DevCheckOG/SPIRIT/EDA-kicad/component-libs/SPIRIT-3D-models/USB-SWITCH-2CHANNEL-TS3USB221AQRSERQ1.stp

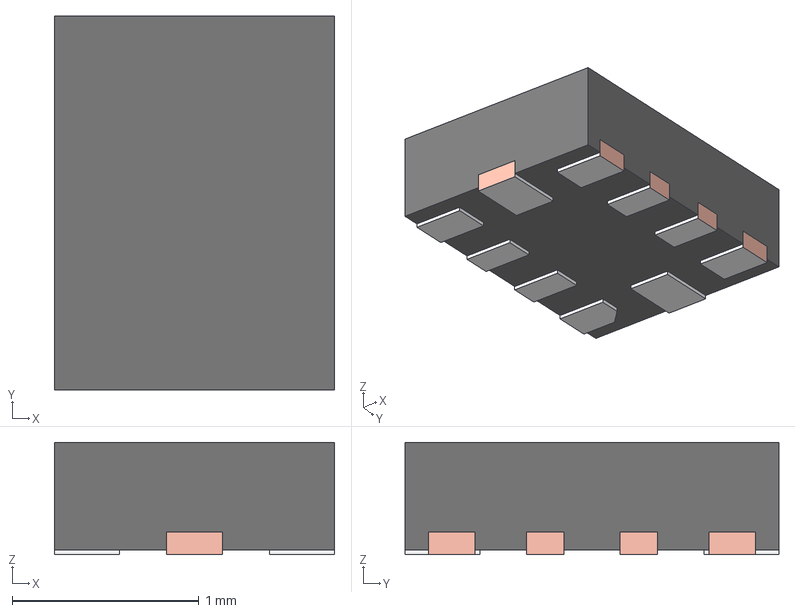
[picture p2: CAD file, 2026-04-25]
EDA-kicad/component-libs/SPIRIT-3D-models/USB-SWITCH-2CHANNEL-TS3USB221AQRSERQ1.stp
1.50 x 2.00 x 0.6 mm
FRAME-RSE0010A
BODY-QFN
PIN1-ID
