DevCheckOG/SPIRIT/EDA-kicad/component-libs/SPIRIT-3D-models/USB-MUX-RHR0028A.stp

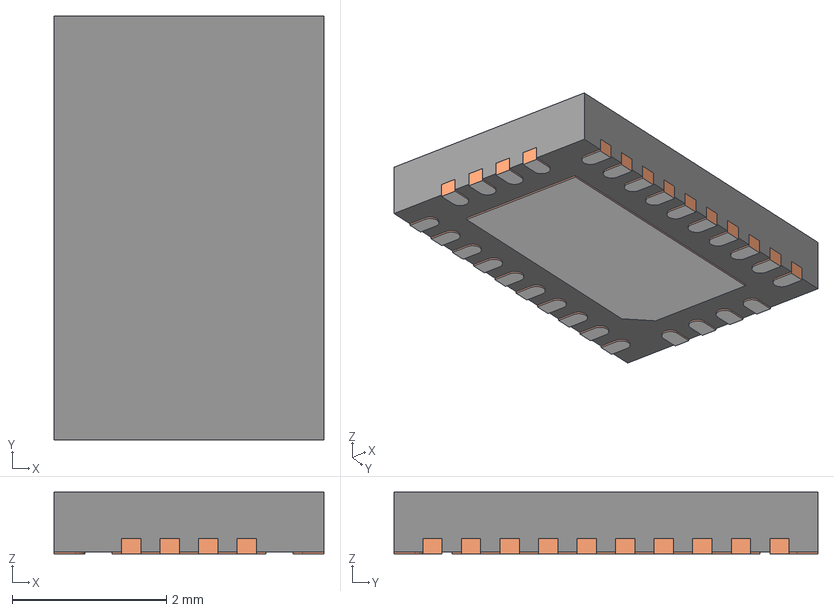
[picture p3: CAD file, 2026-04-25]
EDA-kicad/component-libs/SPIRIT-3D-models/USB-MUX-RHR0028A.stp
3.50 x 5.50 x 0.8 mm
BODY-QFN
FRAME-RHR0028A
PIN1-ID
