DevCheckOG/SPIRIT/EDA-kicad/cm5-carrier.kicad_pcb

## KiCad design EDA-kicad/cm5-carrier.kicad_pcb (2026-04-25)

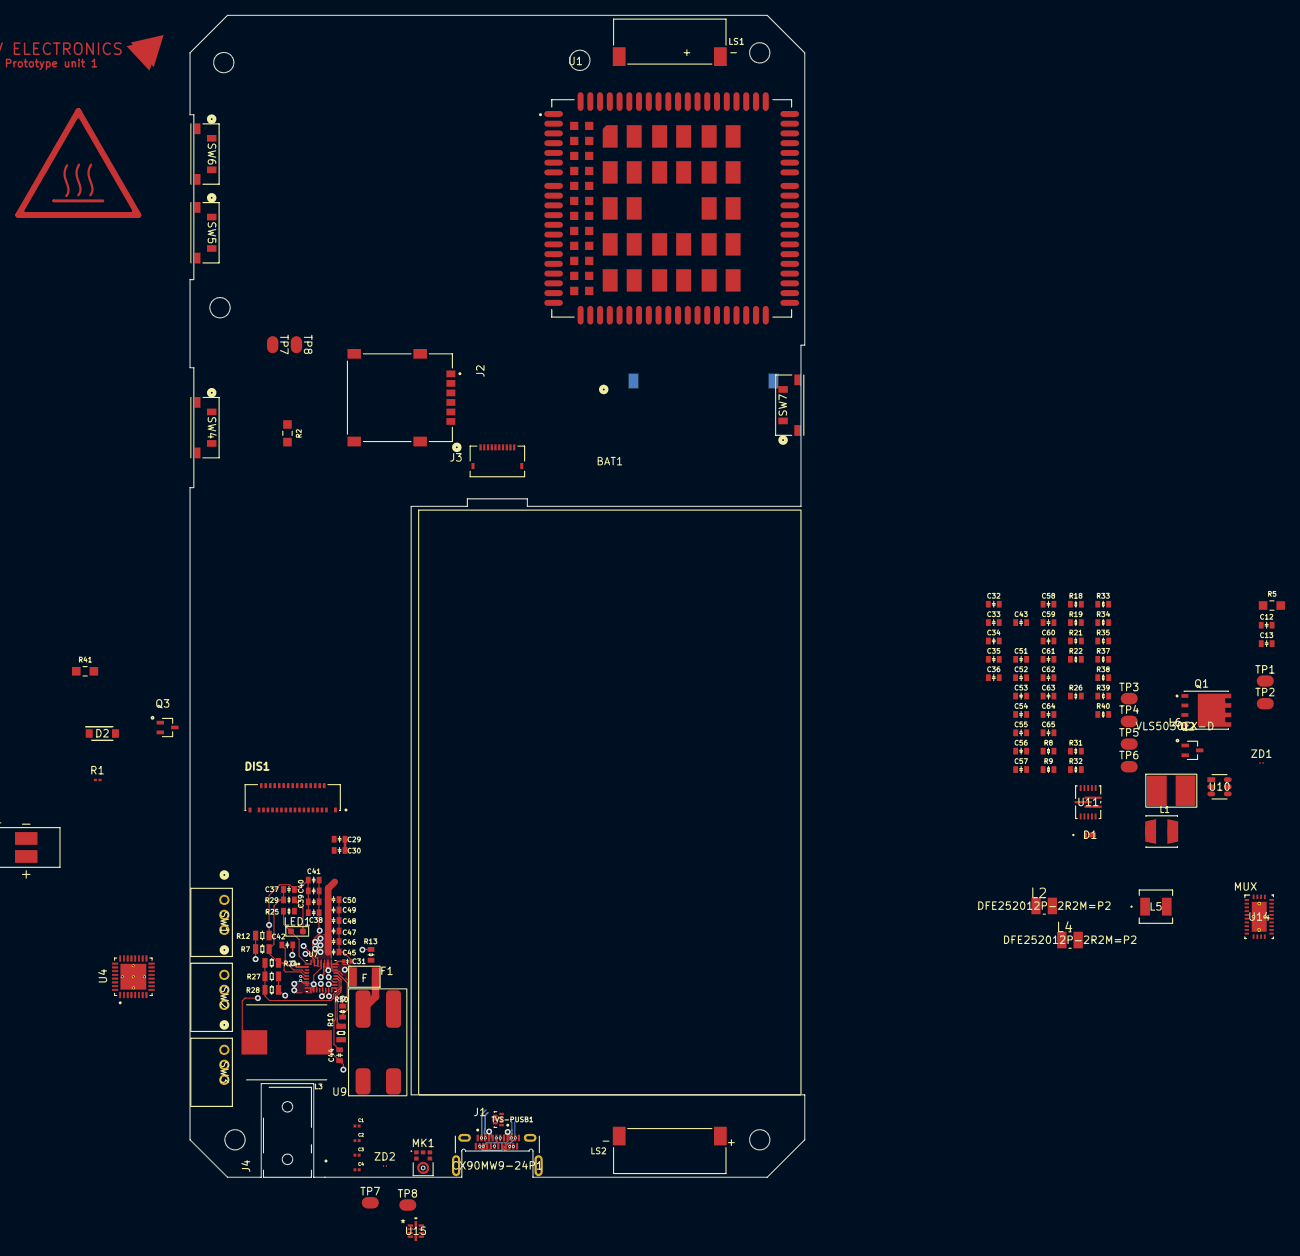
[picture p4: board cm5-carrier.kicad_pcb from above]

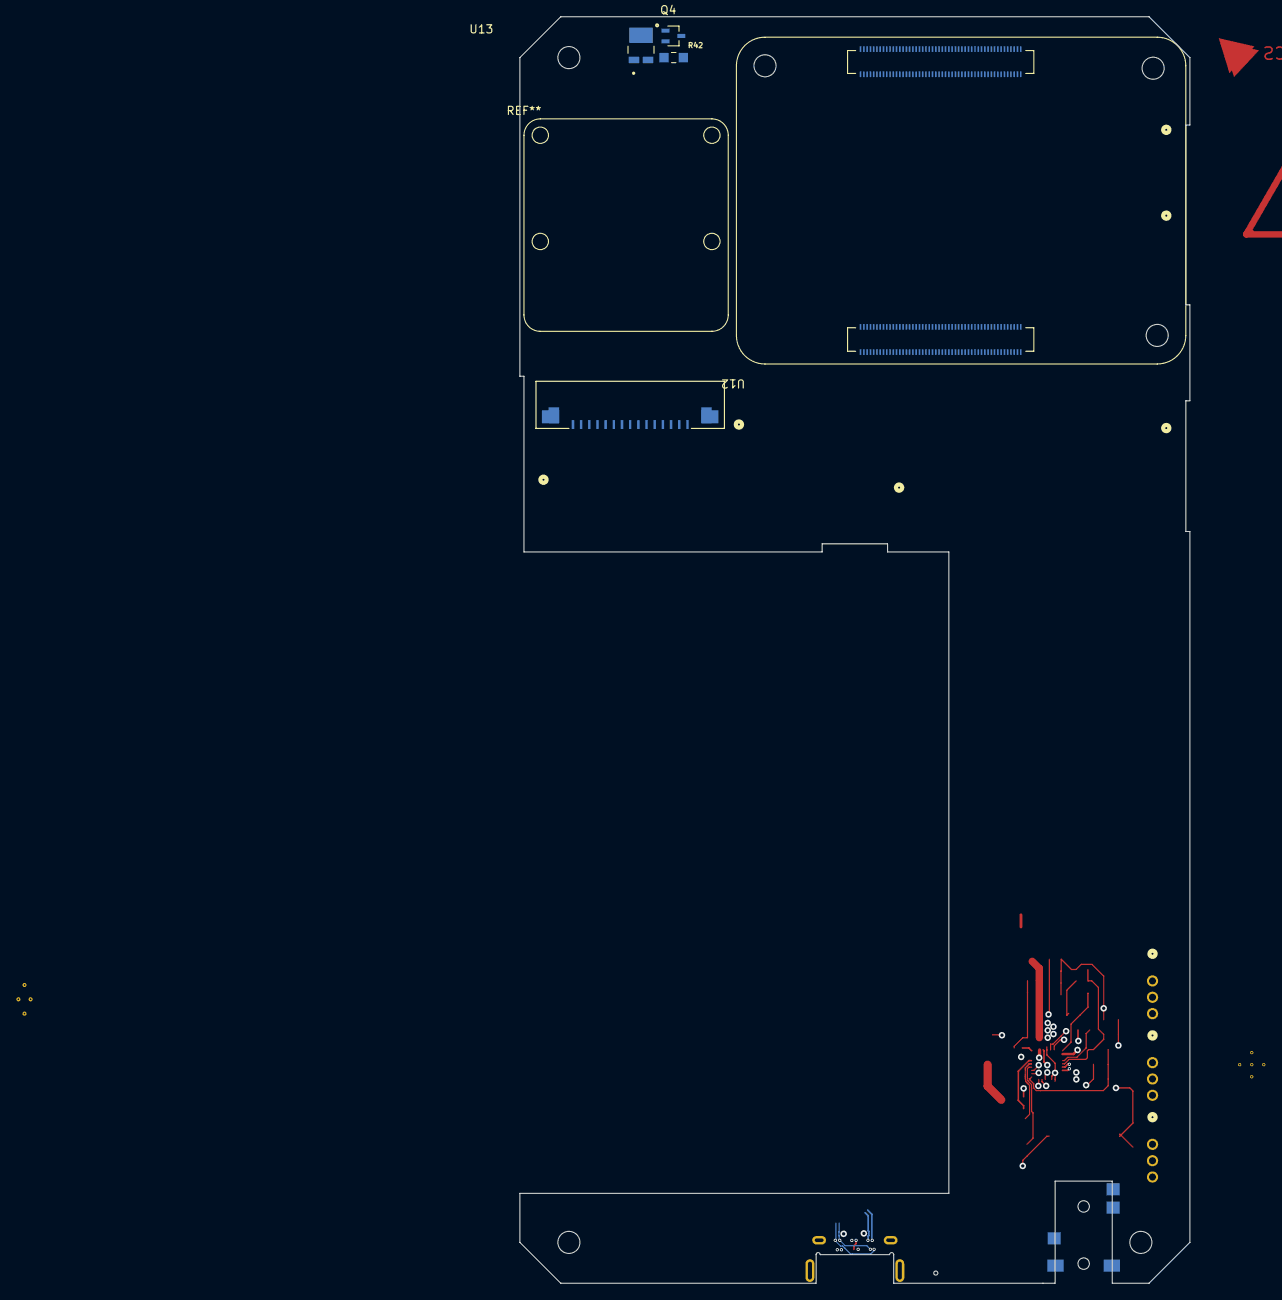
[picture p5: board cm5-carrier.kicad_pcb from below]

Board: 6 copper layers, 82.0 x 155.0 mm, 129 parts (5 on the bottom side), 101 nets.

Parts:
B1: VIBR; VIBRATION-PUI_HD-EMB1205-3-SC-R
BAT1: Li-ion-3.7 35Ah; battery_37V3500mAhLP685077JU
C1, C2, C3, C4: 0.33 µF coupling cap; USBC_capacitor_CAPC0603X33N
C12: 200pF; 0603-capacitor
C13, C38, C45, C55, C59: 0.1uF; 0603-capacitor
C29, C30, C33, C34, C35, C39, C40, C41, C46, C47, C48, C49, C50: 10uF; 0603-capacitor
C31: 1nF 50V; 0402-capacitor
C32, C53, C54: 1uF; 0603-capacitor
C36, C43, C51, C56, C57, C58, C60, C61, C62, C65: 22uF; 0603-capacitor
C37, C52, C64: 4.7uF; 0603-capacitor
C42, C44: 47nF; 0603-capacitor
C63: 6.8nF; 0603-capacitor
D1: D_Schottky; schottky-diode-CR_DSN2_152AB-C_OSI
D2: 1N4007W-T; flyback-diode-SODFL3818X130N
DIS1: FH72-31S-0.3SHW; HRS_FH72-31S-0.3SHW
F1: 9A 6V; PTC RESET FUSE 9.0A 6V 1210 1210L900SLPR
J1: USBC-4-0-CX90MW9-24P1; USB-4-0-HIROSE_CX90MW9-24P1
J2: SIM-G85D1160022HHR; SIM-AMPHENOL_G85D1160022HHR
J3: FINGER; 10PIN
J4: SJ2-35894B-SMT-TR; 35mmJACK-CUI_SJ2-35894B-SMT-TR
L1: 3.3uH; 3-3uH-MURATA_LQH44PN3R3MPRL
L2, L4: 2.2uH; 2-2uH-inductor-INDC2520X120N
L3: 2.2uH; 2-2uh-inductorIND_ETQP4M2R2KVC
L5: 6.8uH; 6-8uH-inductor-LQH44PN6R8MPRLIND_LQH44PN_PR_MUR
L6: 1.5uH; 1-5uH-inductor-VLS5030EX-D
LED1: 5mA 2V Fv; LED-INDICATOR-RED-QBLP601-R5
LS1, LS2: CMR-15062S-67; SPEAKER_CMR-15062S-67
MK1: microphone; microphone_SPH0645LM4H-B
Module1: ComputeModule5-CM5; Raspberry-Pi-5-Compute-Module
Q1: NMOS-BSC0902NSIATMA1-PG-TDSON-8-6-IC_ISC037N03L5ISATMA1
Q2, Q3, Q4: gpio-driver-transistor-fix-SOT65P210X110-3N
R1: thermistor; thermistor-NTC0201Z_P63XP33_PAN
R2: 270KΩ 0.5W; 1K-05W-0805-RES_ERJP06J102V
R5: 100KΩ; 100K-0805-resistor-RES_ERA6AEB104V
R7: 127kΩ; 0805-resistor
R8, R9: 10k; 0603-resistor
R10: 4.7KΩ; 0805-resistor
R12: 100kΩ; 0805-resistor
R13: 100Ω; 0603-resistor
R18, R31, R32, R33: 100kΩ; 0603-resistor
R19: 680kΩ 1%; 0603-resistor
R21, R26: 470kΩ 1%; 0603-resistor
R22: 1MΩ 1%; 0603-resistor
R24: 5.23kΩ; 0805-resistor
R25, R30: 10kΩ; 0603-resistor
R27: 10kΩ; 0805-resistor
R28: 30kΩ; 0805-resistor
R29: 680Ω; 0603-resistor
R34: 820kΩ; 0603-resistor
R35: 182KΩ; 0603-resistor
R37: 5Ω; 0603-resistor
R38: 750kΩ; 0603-resistor
R39: 200kΩ; 0603-resistor
R40: 6.8kΩ; 0603-resistor
R41, R42: 1KΩ 0.5W; 1K-05W-0805-RES_ERJP06J102V
SW1: EG25-switch-CSS-1210MC; privacy-switch-SW3_CSS-1210MC_NDC
SW2: MIC-switch-CSS-1210MC; privacy-switch-SW3_CSS-1210MC_NDC
SW3: CAM-switch-CSS-1210MC; privacy-switch-SW3_CSS-1210MC_NDC
SW4: PROG; buttonSW_TL3330_EWI
SW5: VOL-; buttonSW_TL3330_EWI
SW6: VOL+; buttonSW_TL3330_EWI
SW7: POW; buttonSW_TL3330_EWI
TP1, TP2, TP3, TP4, TP5, TP6, TP7, TP7#2, TP8, TP8#2: test-pad-1
TVS-PUSB1: TVS-array-IC_PUSB3AB6Z
U1: EG25GGC-128-SGNS; XCVR_EG25GGC-128-SGNS
U4: CODEC-TLV320AIC3204IRHBR; CODEC-QFN50P500X500X100-33N
U7: BQ25792RQMR; charger-bq25792-QFN40P400X400X100-29N
U9: BAT-CONNECTOR-FLTS22WR00
U10: 22V-boost-AP3032KTR-G1; SOT23-6_DIO
U11: MP3429GL-Z; QFN-3x4_MP3429_MNP
U12: FPC15pin-1mm-pitch-F52Q-1A7H1-11015; FPC15pin-1mm-pitch-CONN_F52Q-1A7H1-11015_AMP
U13: Flash-LED-Lumiled; LUMILED-DIODFN449X305X210-3N
U14: HD3SS460RHRR; USB-MUX-RHR0028A
U15: USB SWITCH 2CHANNEL TS3USB221AQRSERQ1; USB-SWITCH-2CHANNEL-TS3USB221AQRSERQ1
ZD1, ZD2: protection-PESD5V0C1USFYL; USB-ESD-protection-diode-PESD5V0C1USFYL-SOD962-2_DSN0603-2_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

Connections:
1V8: DIS1.25, SW2.1, U4.24 (AVDD), U4.29 (DVDD)
3V3B: DIS1.30, Module1.78 (GPIO_VREF(1.8v/3.3v_Input)), Q2.3 (S), R8.2, R9.1, R25.2, R30.1, R31.1, R32.1, R33.2, SW3.1, U4.6 (IOVDD), U4.26 (LDOIN/HPVDD), U4.30 (LDO_SELECT)
5V: C59.1, C60.1, C61.1, C62.1, Module1.77 (+5v_(Input)), Module1.79 (+5v_(Input)), Module1.81 (+5v_(Input)), Module1.83 (+5v_(Input)), Module1.85 (+5v_(Input)), Module1.87 (+5v_(Input)), R38.1, U11.8 (VOUT)
22V: C53.1, D1.1 (K), DIS1.2, U10.5 (OV)
AGND: C65.2, R39.2, R40.2, U11.6 (AGND), U11.9 (FTY)
AUDIO_BCLK_I2S: MK1.4 (BCLK), Module1.49 (GPIO18), U4.2 (BCLK)
AUDIO_MCLK: Module1.54 (GPIO4), U4.1 (MCLK)
AUDIO_MIC_DATA: Module1.27 (GPIO20), U4.5 (DOUT/MFP2)
AUDIO_RESET: Module1.45 (GPIO24), U4.31 (~RESET)
AUDIO_SCL: Module1.51 (GPIO15), U4.9 (SCL/~SS)
AUDIO_SDA: Module1.31 (GPIO12), U4.10 (SDA/MOSI)
AUDIO_SOUND_DATA: Module1.25 (GPIO21), U4.4 (DIN/MFP1)
AUDIO_WCLK_I2S: MK1.1 (WS), Module1.26 (GPIO19), U4.3 (WCLK)
BACKLIGHT-: DIS1.31, R37.1, U10.3 (FB)
BAT+: C29.1, C30.1, F1.2, R13.2, U7.22 (BAT), U7.23 (BAT__1)
CAM-SWITCH: TP7.1 (A), U12.15
CAM_CK_N: Module1.127 (MIPI0_C_N), U12.8
CAM_CK_P: Module1.129 (MIPI0_C_P), U12.9
CAM_D0_N: Module1.115 (MIPI0_D0_N), U12.2
CAM_D0_P: Module1.117 (MIPI0_D0_P), U12.3
CAM_D1_N: Module1.121 (MIPI0_D1_N), U12.5
CAM_D1_P: Module1.123 (MIPI0_D1_P), U12.6
CAM_IO0: TP8.1 (A), U12.11
CC1: J1.A5 (CC1), Module1.94 (CC1)
CC2: J1.B5 (CC2), Module1.96 (CC2)
D+: J1.A6 (D1+), J1.B6 (D2+), Module1.163 (USB3-1-D_P), TVS-PUSB1.5 (D+), U7.6 (D+)
D-: J1.A7 (D1-), J1.B7 (D2-), Module1.165 (USB3-1-D_N), TVS-PUSB1.4 (D-), U7.7 (D-)
DEFDCDC1 DIVIDER: C36.1, L1.1, R34.1
DSI1_C_N: DIS1.11, Module1.187 (MIPI1_C_N)
DSI1_C_P: DIS1.12, Module1.189 (MIPI1_C_P)
DSI1_D0_N: DIS1.5, Module1.175 (MIPI1_D0_N)
DSI1_D0_P: DIS1.6, Module1.177 (MIPI1_D0_P)
DSI1_D1_N: DIS1.8, Module1.181 (MIPI1_D1_N)
DSI1_D1_P: DIS1.9, Module1.183 (MIPI1_D1_P)
DSI1_D2_N: DIS1.14, Module1.133 (MIPI0_D2_N), Module1.193 (MIPI1_D2_N)
DSI1_D2_P: DIS1.15, Module1.135 (MIPI0_D2_P), Module1.195 (MIPI1_D2_P)
GND: C12.1, C13.2, C29.2, C30.2, C31.2, C32.2, C33.2, C34.2, C35.2, C36.2, C37.2, C38.2, C39.2, C40.2, C41.2, C43.2, C45.2, C46.2, C47.2, C48.2, C49.2, C50.2, C51.2, C52.1, C53.2, C54.2, C56.2, C57.2, C58.2, C59.2, C60.2, C61.2, C62.2, C64.1, DIS1.1, DIS1.4, DIS1.7, DIS1.10, DIS1.13, DIS1.16, DIS1.19, DIS1.20, J1.A1 (GND_A), J1.A12 (GND_A__1), J1.B1 (GND_B), J1.B12 (GND_B__1), J1.SH1 (SHIELD), J1.SH2 (SHIELD__1), J1.SH3 (SHIELD__2), J1.SH4 (SHIELD__3), J2.C5 (GND), J2.S1 (SHIELD_GND), J2.S2 (SHIELD_GND__1), J2.S3 (SHIELD_GND__2), J3.1, J4.1, MK1.2 (SELECT), MK1.3 (GND), Module1.1 (GND), Module1.2 (GND), Module1.8 (GND), Module1.13 (GND), Module1.14 (GND), Module1.22 (GND), Module1.23 (GND), Module1.32 (GND), Module1.33 (GND), Module1.42 (GND), Module1.43 (GND), Module1.52 (GND), Module1.53 (GND), Module1.60 (GND), Module1.66 (GND), Module1.71 (GND), Module1.74 (GND), Module1.98 (GND), Module1.107 (GND), Module1.108 (GND), Module1.113 (GND), Module1.114 (GND), Module1.119 (GND), Module1.120 (GND), Module1.125 (GND), Module1.126 (GND), Module1.131 (GND), Module1.132 (GND), Module1.137 (GND), Module1.138 (GND), Module1.144 (GND), Module1.150 (GND), Module1.155 (GND), Module1.156 (GND), Module1.161 (GND), Module1.162 (GND), Module1.167 (GND), Module1.168 (GND), Module1.173 (GND), Module1.174 (GND), Module1.179 (GND), Module1.180 (GND), Module1.185 (GND), Module1.186 (GND), Module1.191 (GND), Module1.192 (GND), Module1.197 (GND), Module1.198 (GND), Q3.3 (S), Q4.3 (S), R5.1, R10.1, R12.2, R21.1, R26.1, R27.2, R28.2, R35.1, R37.2, TVS-PUSB1.2 (GND), U4.7 (IOVSS), U4.12 (SPI_SELECT), U4.17 (AVSS), U4.28 (DVSS), U4.33 (EP), U7.10 (ACDRV2), U7.11 (ACDRV1), U7.27 (GND), U9.4 (OUT-), U10.2 (GND), U11.7 (PGND), U12.1, U12.4, U12.10, ZD1.2, ZD2.2
GPIO2: Module1.58 (GPIO2), SW7.2
GPIO3: Module1.56 (GPIO3), SW6.2
GPIO17: Module1.50 (GPIO17), SW4.2
GPIO22: Module1.46 (GPIO22), R42.1
GPIO27: Module1.48 (GPIO27), R41.1
JACK_MIC: J4.4, U4.8 (SCLK/MFP3)
LCD_PWM: Module1.55 (GPIO14), U10.4 (CTRL)
MIC-SWITCH: C12.2, C13.1, MK1.5 (VDD)
unnamed: C63.2, R40.1
unnamed: D1.2 (A), L5.2, U10.1 (SW)
unnamed: J3.8, R2.2
unnamed: LED1.2 (A), R29.1
unnamed: LED1.1 (K), R25.1, U7.1 (STAT)
unnamed: MK1.6 (DATA_OUT), R5.2
unnamed: C1.1, Module1.157 (USB3-1-RX_N)
unnamed: C2.1, Module1.159 (USB3-1-RX_P)
unnamed: C3.1, Module1.169 (USB3-1-TX_N)
unnamed: C4.1, Module1.171 (USB3-1-TX_P)
unnamed: Q2.1 (G), SW3.2
unnamed: B1.N, D2.2, Q3.2 (D)
unnamed: Q3.1 (G), R41.2
unnamed: Q4.2 (D), U13.1 (-)
unnamed: Q4.1 (G), R42.2
unnamed: C52.2, TP5.1 (A)
unnamed: R13.1, U7.18 (BATP)
unnamed: C42.2, U7.4 (BTST1)
unnamed: C44.2, U7.19 (BTST2)
unnamed: R7.1, R12.1, U7.17 (ILIM_HIZ)
unnamed: C38.1, C39.1, C40.1, C41.1, U7.29 (PMID)
unnamed: R10.2, U7.20 (PROG)
unnamed: C31.1, U7.24 (SDRV)
unnamed: C42.1, L3.2, U7.28 (SW1)
unnamed: C44.1, L3.1, U7.26 (SW2)
unnamed: R24.2, R27.1, R28.1, U7.16 (TS)
unnamed: R34.2, R35.2
unnamed: R22.1, R26.2
unnamed: R19.1, R21.2
unnamed: C32.1, R18.1
unnamed: C43.1, L2.1
unnamed: C51.1, L4.1
unnamed: F1.1, U9.3 (OUT+)
unnamed: C55.1, U11.13 (BST)
unnamed: C63.1, U11.4 (COMP)
unnamed: R38.2, R39.1, U11.5 (FB)
unnamed: C65.1, U11.3 (SS)
unnamed: C55.2, L6.2, U11.1 (SW)
unnamed: C64.2, U11.2 (VDD)
REGN: C37.1, R7.2, R24.1, R29.2, U7.5 (REGN)
RX1+: C2.2, J1.A11 (RX2+), J1.B11 (RX1+), TVS-PUSB1.7 (RX+)
RX1-: C1.2, J1.A10 (RX2-), J1.B10 (RX1-), TVS-PUSB1.6 (Rx-)
SCL PWR: Module1.80 (SCL0), U7.14 (SCL)
SDA PWR: Module1.82 (SDA0), U7.15 (SDA)
SPI0_CLK: J3.2, Module1.38 (GPIO11)
SPI0_CS: J3.5, Module1.39 (GPIO8)
SPI0_MISO: J3.3, Module1.40 (GPIO9)
SPI0_MOSI: J3.4, Module1.44 (GPIO10)
SPI0_RDY: J3.6, Module1.34 (GPIO5)
SYS: C45.1, C46.1, C47.1, C48.1, C49.1, C50.1, C54.1, C56.1, C57.1, C58.1, L5.1, L6.1, R19.2, R22.2, U7.25 (SYS), U10.6 (VIN), U11.10 (MODE), U11.11 (EN), U11.12 (VIN)
TX1+: C4.2, J1.A2 (TX1+), J1.B2 (TX2+), TVS-PUSB1.3 (Tx+)
TX1-: C3.2, J1.A3 (TX1-), J1.B3 (TX2-), TVS-PUSB1.1 (Tx-)
USBC POW: J1.A4 (VBUS_A), J1.A9 (VBUS_A__1), J1.B4 (VBUS_B), J1.B9 (VBUS_B__1), U7.2 (VBUS), U7.8 (VAC2), U7.9 (VAC1), ZD1.1, ZD2.1
VCC: B1.P, D2.1, J3.7, J3.10, R2.1, SW4.1, SW5.1, SW6.1, SW7.1, U13.2 (+)
~BQ INT: R30.2, U7.21 (~INT)
~TPS INT: R31.2, TP6.1 (A)
