DevCheckOG/SPIRIT/(commit log)

2026-03-19 fix bad label 3V3
    [power.kicad_sch]
2026-03-19 pull up I2C line of TPS
    [power.kicad_sch]
2026-03-19 Fixed audio schematic file name
    [audio.kicad_sch, cm5-carrier.kicad_sch, power.kicad_sch]
2026-03-19 Finished audio schematic
    [audio.kicad_sch, cm5-carrier.kicad_sch]
2026-03-22 change netflaf for microphone switch to be 1V8 instead of 3V3B, GPS/GSM symbol
    [GSM-GPS.kicad_sch, power.kicad_sch]
2026-03-22 reannotate entire schematic
    [GSM-GPS.kicad_sch, USB-C.kicad_sch, audio.kicad_sch, buttons.kicad_sch, camera.kicad_sch, cm5-carrier.kicad_sch, fingerprint.kicad_sch, flashlight.kicad_sch]
2026-03-22 broken connection, change flags to 3V3B labels
    [power.kicad_sch]
2026-03-22 screen GND ref
    [screen.kicad_sch]
2026-03-22 charger 50% routed
    [cm5-carrier.kicad_pcb, cm5-carrier.kicad_sch, power.kicad_sch]
2026-03-23 update schematic PDF
2026-03-24 connect GPIO VREF to 3V3B
    [cm5-carrier.kicad_sch]
2026-03-24 remove redundant pull ups, connect charger and PMIC on single I2C bus
    [cm5-carrier.kicad_sch, power.kicad_sch]
2026-03-24 routed charger
    [cm5-carrier.kicad_pcb]
2026-03-24 add MPN to USB C symbol
    [USB-C.kicad_sch]
2026-03-24 fix USB C cutout
    [cm5-carrier.kicad_pcb]
2026-04-25 add USB-MUX HD3SS460
    [USB-C.kicad_sch, USB-MUX-RHR0028A.stp, cm5-carrier.kicad_pcb]
2026-04-25 add USB 2 switch
    [USB-C.kicad_sch, USB-SWITCH-2CHANNEL-TS3USB221AQRSERQ1.stp, cm5-carrier.kicad_pcb]
2026-04-25 connect USB switch
    [USB-C.kicad_sch, cm5-carrier.kicad_sch, power.kicad_sch]
2026-04-25 change some labels
    [camera.kicad_sch, power.kicad_sch]
2026-04-25 connect charger to usb switch
    [power.kicad_sch]
2026-04-25 initial MUX connections
    [USB-C.kicad_sch]
2026-04-28 add image of selected MUX config
    [USB-C.kicad_sch]
